mhrahimi/3d_printables/docs/images/01_example_wall.png

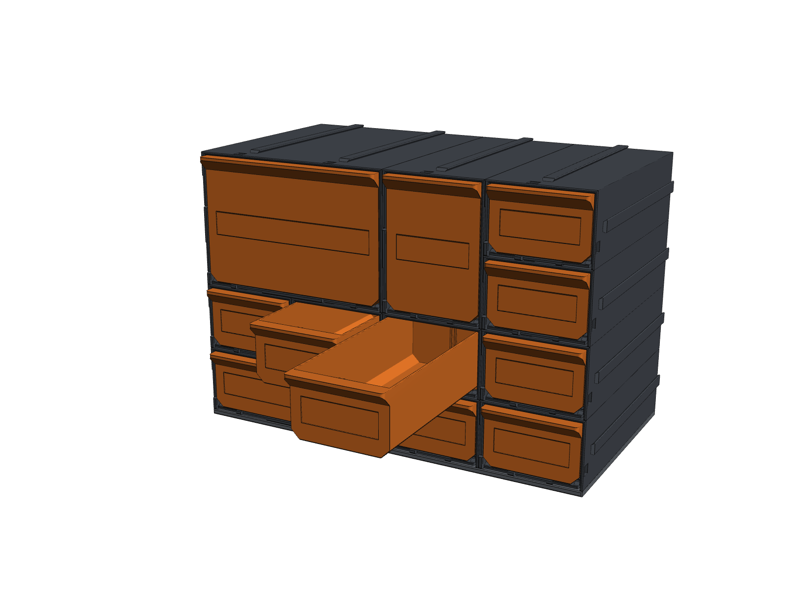
docs/images/01_example_wall.png
