mhrahimi/3d_printables/docs/images/02_example_wall_side.png

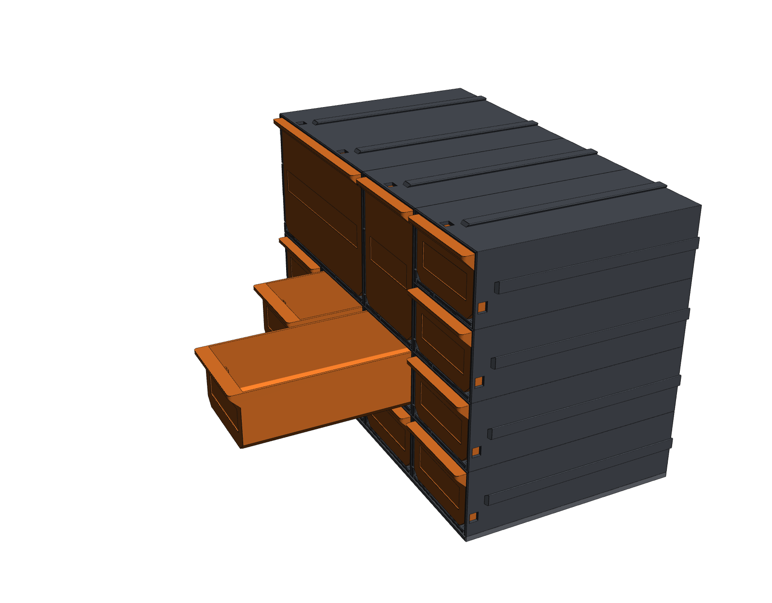
docs/images/02_example_wall_side.png
