mhrahimi/3d_printables/docs/images/03_module_1x1.png

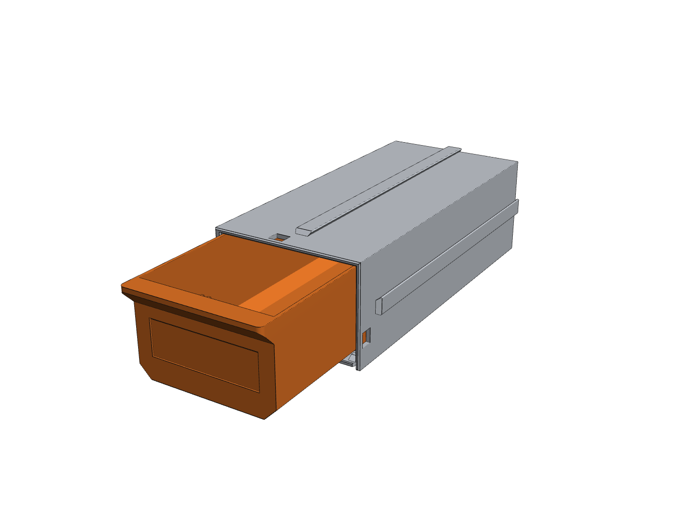
docs/images/03_module_1x1.png
