mhrahimi/3d_printables/docs/images/04_case_rear_bottom.png

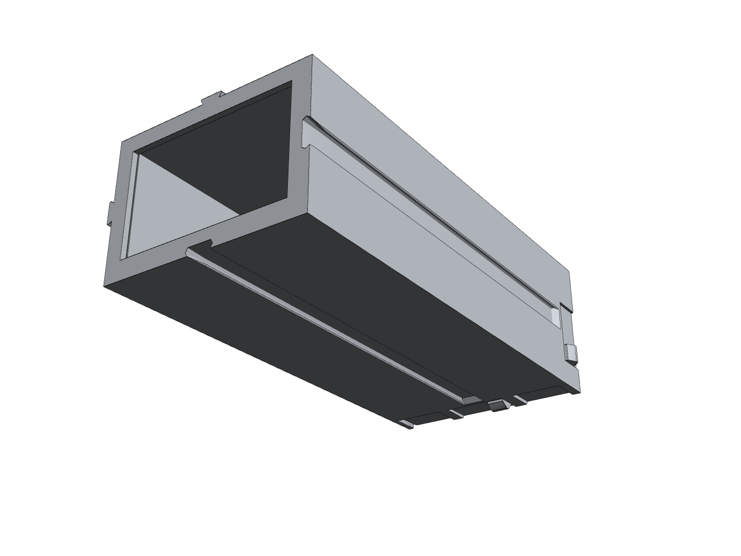
docs/images/04_case_rear_bottom.png
