mhrahimi/3d_printables/docs/images/05_joining_modules.png

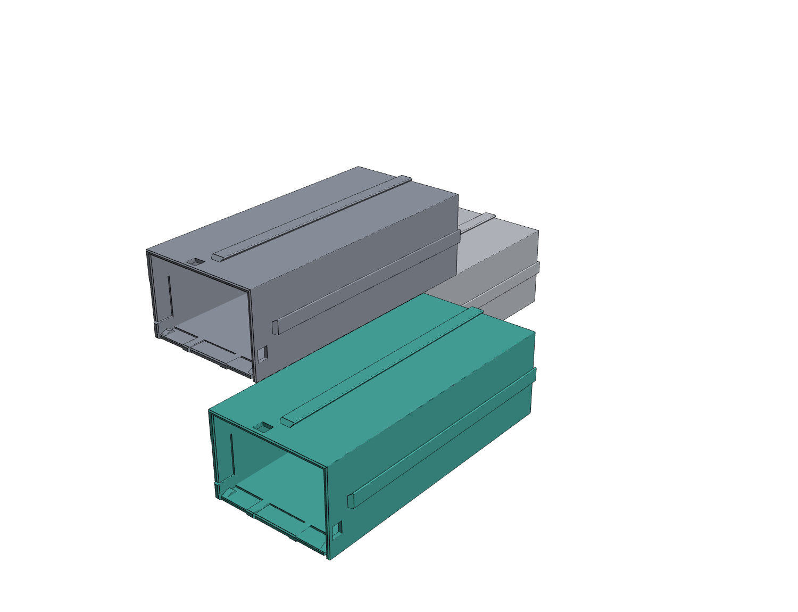
docs/images/05_joining_modules.png
