mhrahimi/3d_printables/docs/images/06_section_dovetail.png

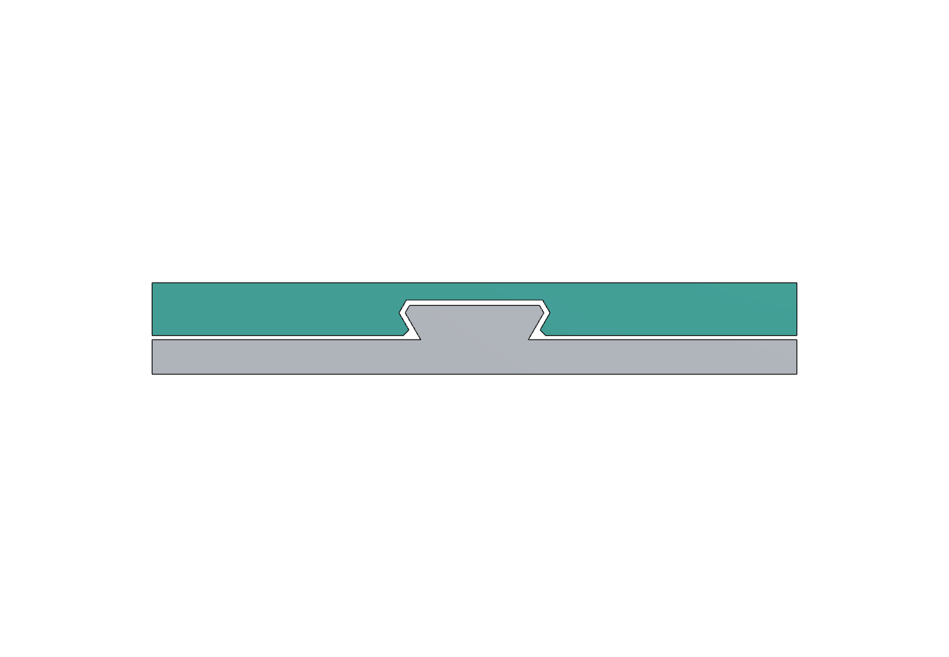
docs/images/06_section_dovetail.png
