mhrahimi/3d_printables/docs/images/07_section_lock.png

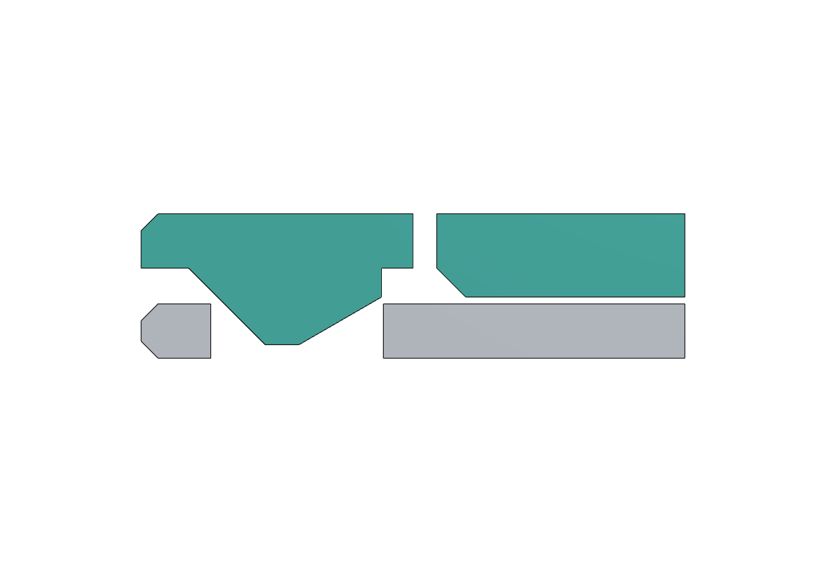
docs/images/07_section_lock.png
