mhrahimi/3d_printables/docs/images/08_section_drawer_stop.png

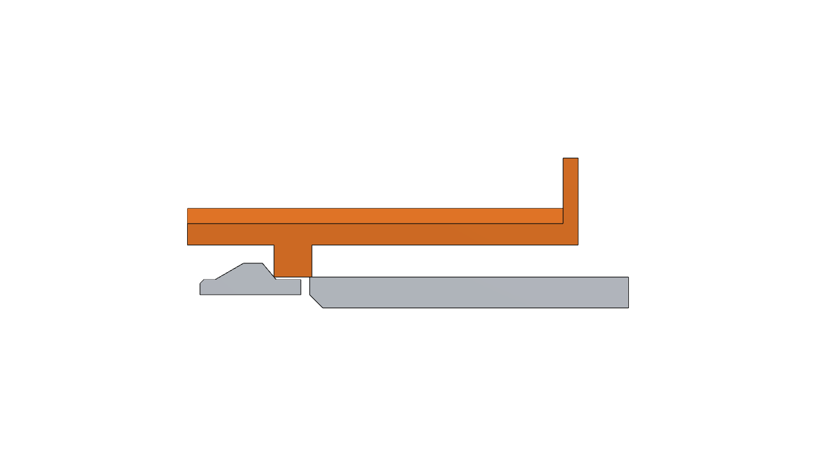
docs/images/08_section_drawer_stop.png
