mhrahimi/3d_printables/docs/images/09_drawer_at_stop.png

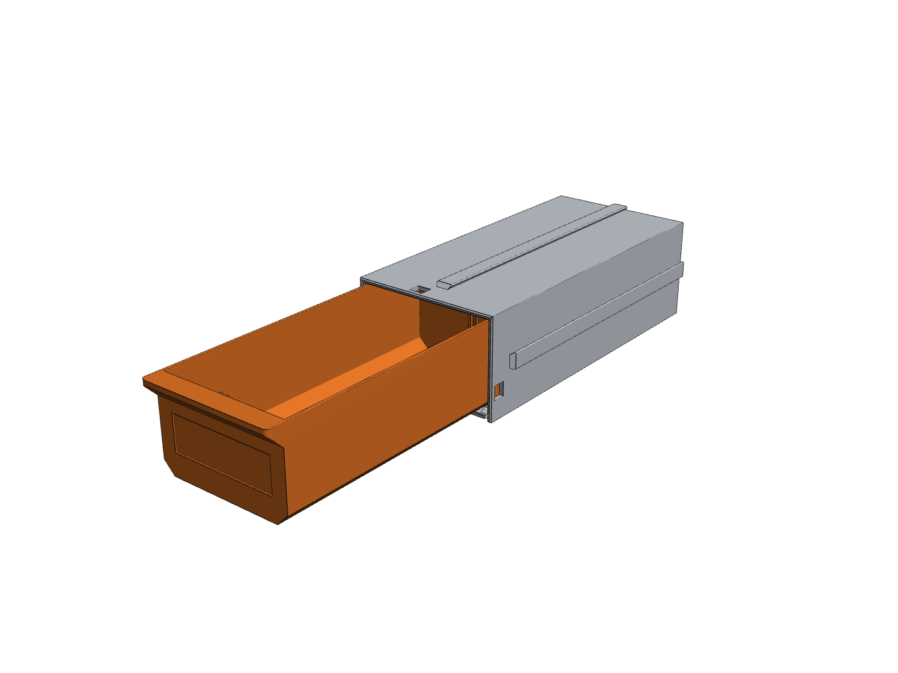
docs/images/09_drawer_at_stop.png
