mhrahimi/3d_printables/docs/images/10_flexures_from_below.png

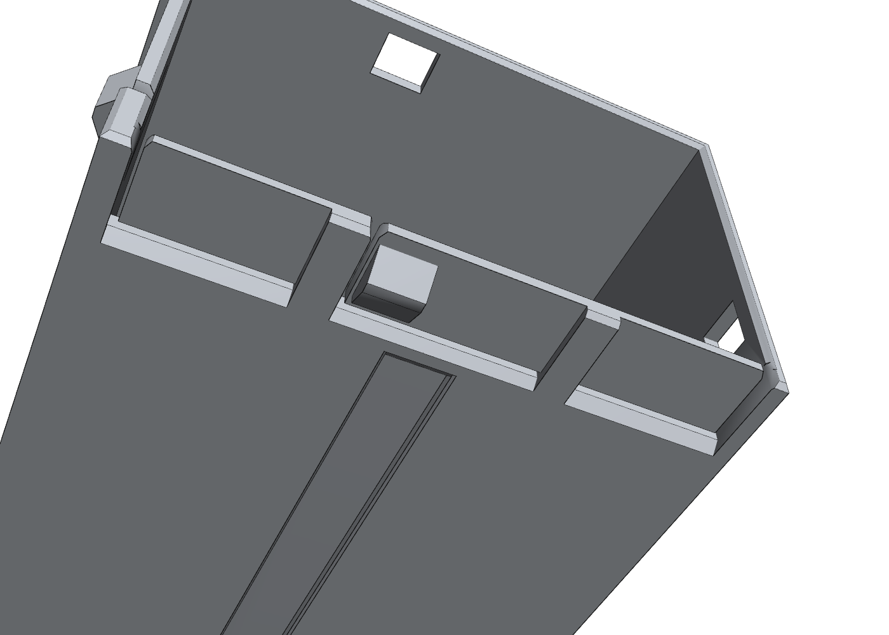
docs/images/10_flexures_from_below.png
