mhrahimi/3d_printables/docs/images/11_flexures_inside.png

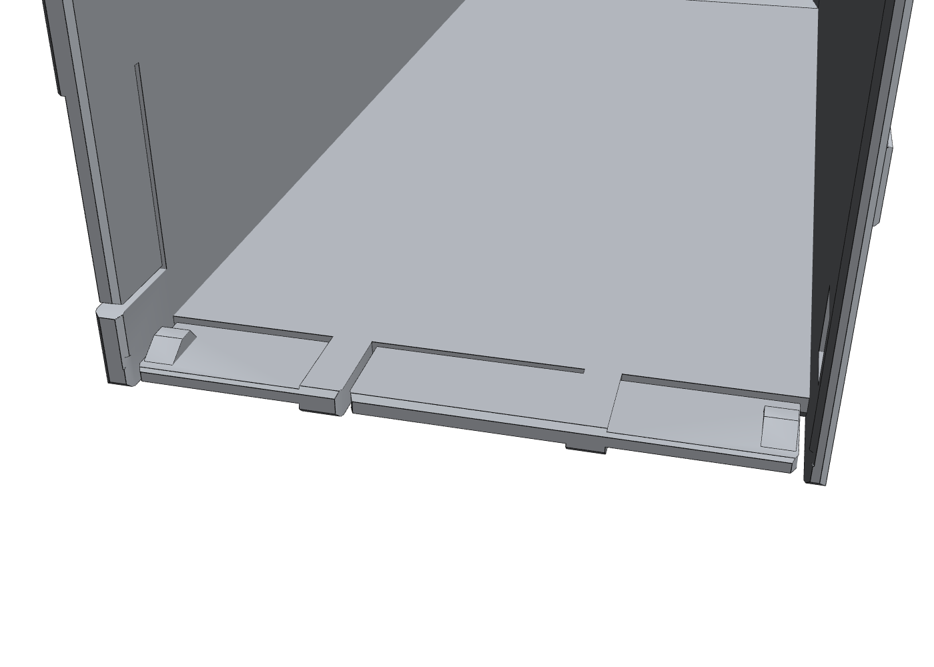
docs/images/11_flexures_inside.png
