mhrahimi/3d_printables/docs/images/12_drawer_1x1.png

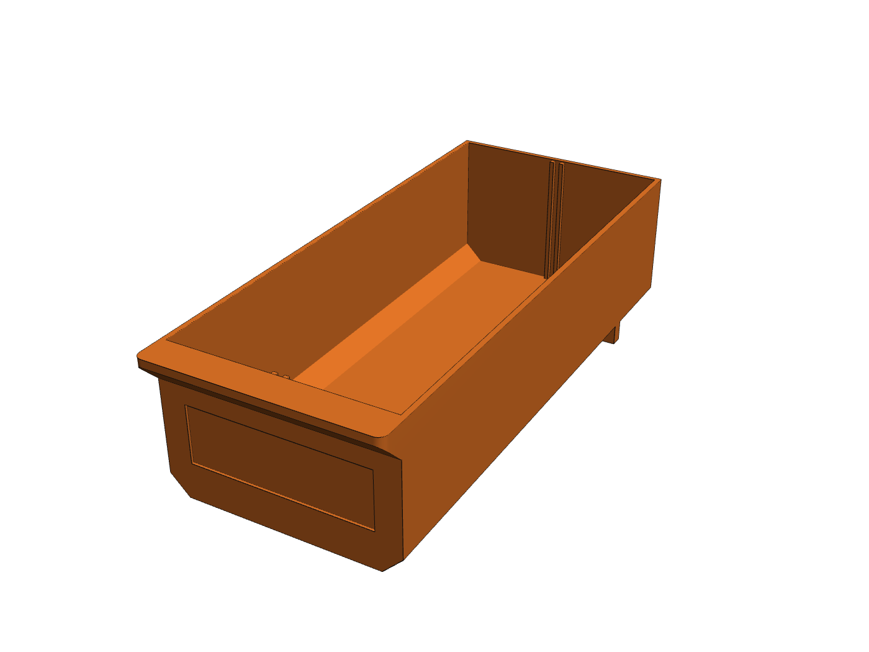
docs/images/12_drawer_1x1.png
