mhrahimi/3d_printables/docs/images/13_drawer_underside.png

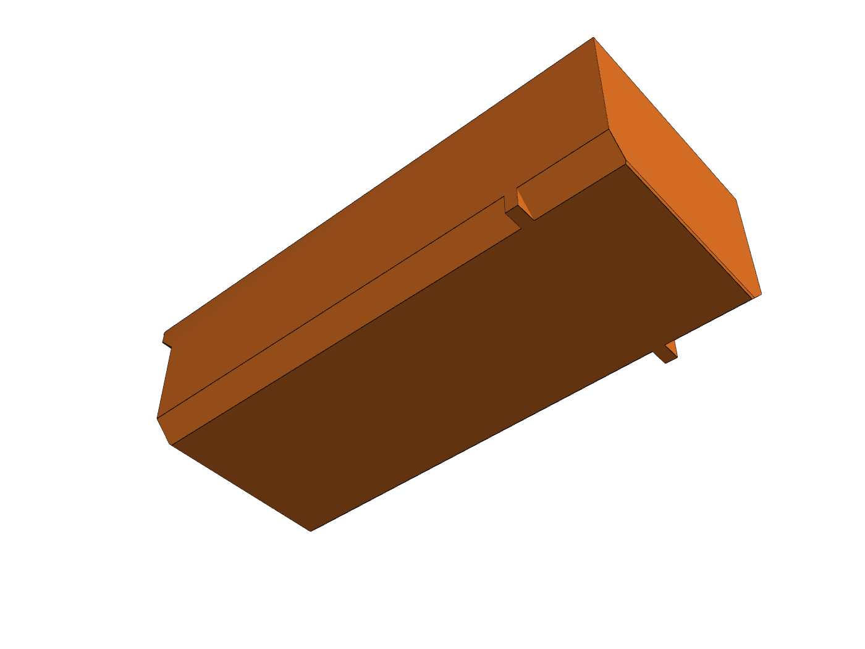
docs/images/13_drawer_underside.png
