mhrahimi/3d_printables/models/reports/parts.csv

part | kind | print_x | print_y | print_z | volume_cm3 | PLA_g | PETG_g
case_1x1 | case | 62.8 | 42.8 | 130.0 | 50.8 | 63.0 | 65.0
drawer_1x1 | drawer | 55.0 | 131.4 | 35.2 | 25.7 | 32.0 | 33.0
case_2x1 | case | 122.8 | 42.8 | 130.0 | 83.1 | 103.0 | 106.0
drawer_2x1 | drawer | 115.1 | 131.4 | 35.2 | 43.9 | 54.0 | 56.0
case_3x1 | case | 182.8 | 42.8 | 130.0 | 115.4 | 143.0 | 147.0
drawer_3x1 | drawer | 175.1 | 131.4 | 35.2 | 62.0 | 77.0 | 79.0
case_4x1 | case | 242.8 | 42.8 | 130.0 | 147.7 | 183.0 | 188.0
drawer_4x1 | drawer | 235.1 | 131.4 | 35.2 | 80.2 | 99.0 | 102.0
case_1x2 | case | 62.8 | 82.8 | 130.0 | 72.2 | 90.0 | 92.0
drawer_1x2 | drawer | 55.0 | 131.4 | 75.2 | 44.7 | 55.0 | 57.0
case_2x2 | case | 122.8 | 82.8 | 130.0 | 104.5 | 130.0 | 133.0
drawer_2x2 | drawer | 115.1 | 131.4 | 75.2 | 70.9 | 88.0 | 90.0
case_3x2 | case | 182.8 | 82.8 | 130.0 | 136.9 | 170.0 | 174.0
drawer_3x2 | drawer | 175.1 | 131.4 | 75.2 | 97.1 | 120.0 | 123.0
case_4x2 | case | 242.8 | 82.8 | 130.0 | 169.2 | 210.0 | 215.0
drawer_4x2 | drawer | 235.1 | 131.4 | 75.2 | 123.4 | 153.0 | 157.0
divider_h1 | divider | 121.7 | 33.2 | 1.2 | 4.8 | 6.0 | 6.0
divider_h2 | divider | 121.7 | 73.2 | 1.2 | 10.6 | 13.0 | 13.0
base_1 | base | 59.8 | 130.0 | 4.6 | 24.3 | 30.0 | 31.0
base_2 | base | 119.8 | 130.0 | 4.6 | 48.7 | 60.0 | 62.0
base_3 | base | 179.8 | 130.0 | 4.6 | 73.1 | 91.0 | 93.0
base_4 | base | 239.8 | 130.0 | 4.6 | 97.5 | 121.0 | 124.0
test_rail | coupon_rail | 28.0 | 10.2 | 30.0 | 2.1 | 3.0 | 3.0
test_groove_0.15mm_1notch | coupon_groove | 28.0 | 10.9 | 30.0 | 2.4 | 3.0 | 3.0
test_groove_0.20mm_2notch | coupon_groove | 28.0 | 10.9 | 30.0 | 2.4 | 3.0 | 3.0
test_groove_0.25mm_3notch | coupon_groove | 28.0 | 10.9 | 30.0 | 2.4 | 3.0 | 3.0
test_groove_0.30mm_4notch | coupon_groove | 28.0 | 10.9 | 30.0 | 2.4 | 3.0 | 3.0
test_groove_0.35mm_5notch | coupon_groove | 28.0 | 10.9 | 30.0 | 2.4 | 3.0 | 3.0
test_mini_case_1x1 | case | 62.8 | 42.8 | 48.0 | 19.3 | 24.0 | 25.0
test_mini_drawer_1x1 | drawer | 55.0 | 49.5 | 35.2 | 14.1 | 18.0 | 18.0
