mhrahimi/3d_printables/models/step/test_groove_0.25mm_3notch.step

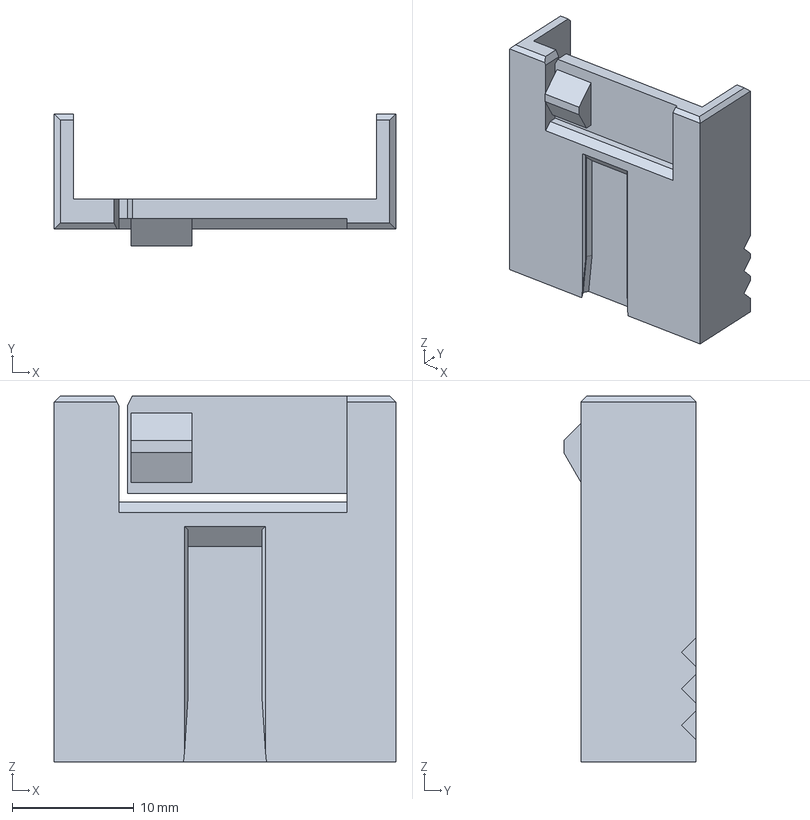
[picture p17: CAD file, 2026-11-12]
models/step/test_groove_0.25mm_3notch.step
28.0 x 10.9 x 30.0 mm
