mhrahimi/3d_printables/models/step/base_3.step

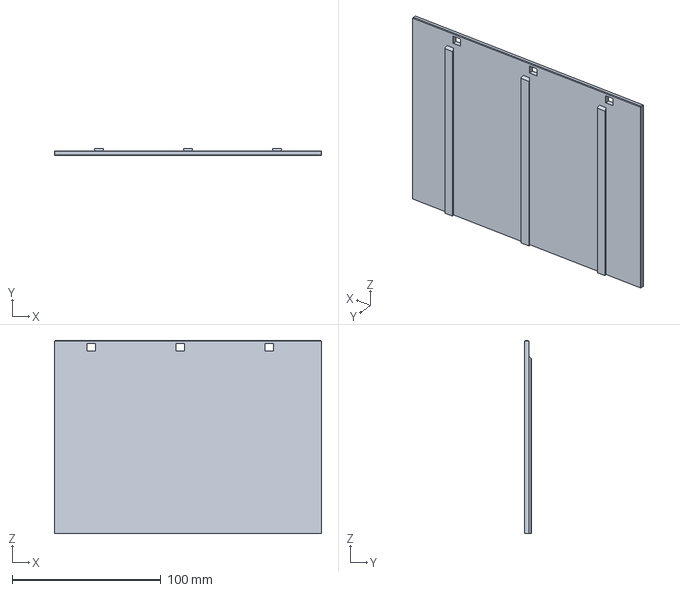
[picture p19: CAD file, 2026-11-12]
models/step/base_3.step
179.8 x 4.60 x 130.0 mm
