mhrahimi/3d_printables/models/step/test_rail.step

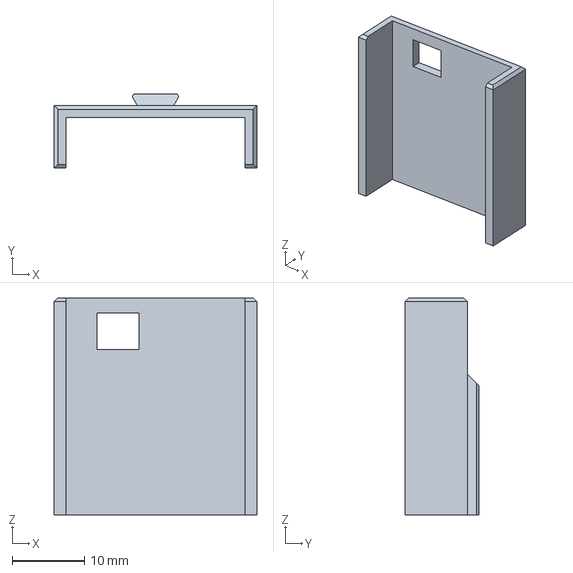
[picture p21: CAD file, 2026-11-12]
models/step/test_rail.step
28.0 x 10.2 x 30.0 mm
