mhrahimi/3d_printables/models/step/case_3x2.step

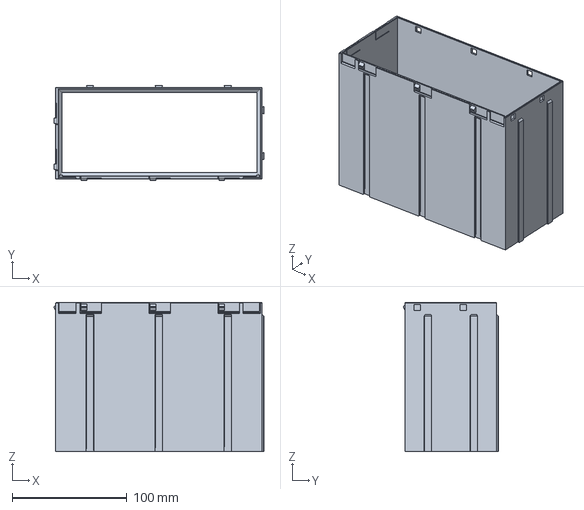
[picture p22: CAD file, 2026-11-12]
models/step/case_3x2.step
182.8 x 82.8 x 130.0 mm
