mhrahimi/3d_printables/models/step/case_2x1.step

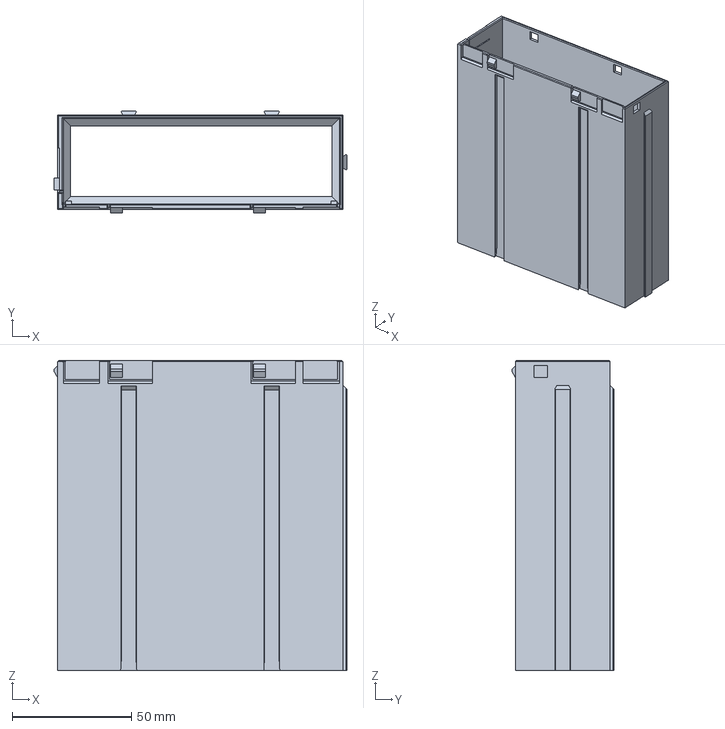
[picture p23: CAD file, 2026-11-12]
models/step/case_2x1.step
122.8 x 42.8 x 130.0 mm
