mhrahimi/3d_printables/models/step/drawer_4x1.step

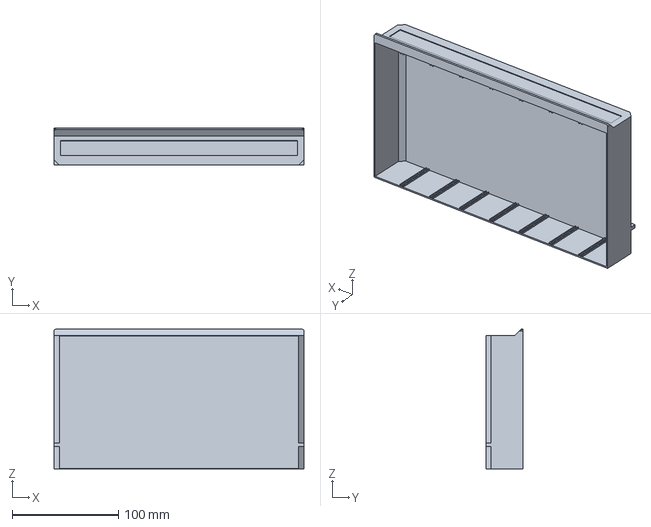
[picture p24: CAD file, 2026-11-12]
models/step/drawer_4x1.step
235.0 x 35.2 x 131.4 mm
