mhrahimi/3d_printables/models/step/drawer_1x1.step

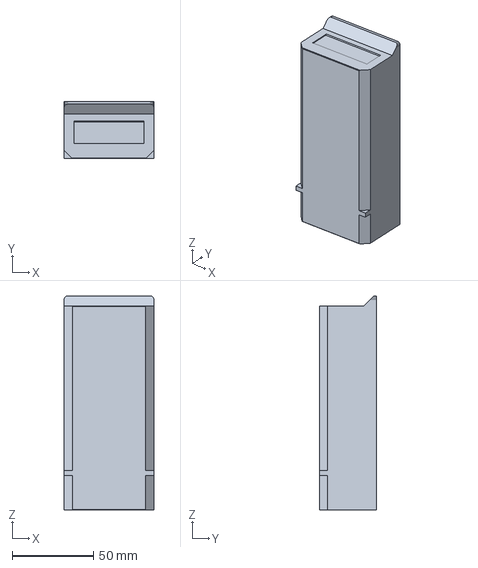
[picture p25: CAD file, 2026-11-12]
models/step/drawer_1x1.step
55.1 x 35.2 x 131.4 mm
