mhrahimi/3d_printables/models/step/case_4x1.step

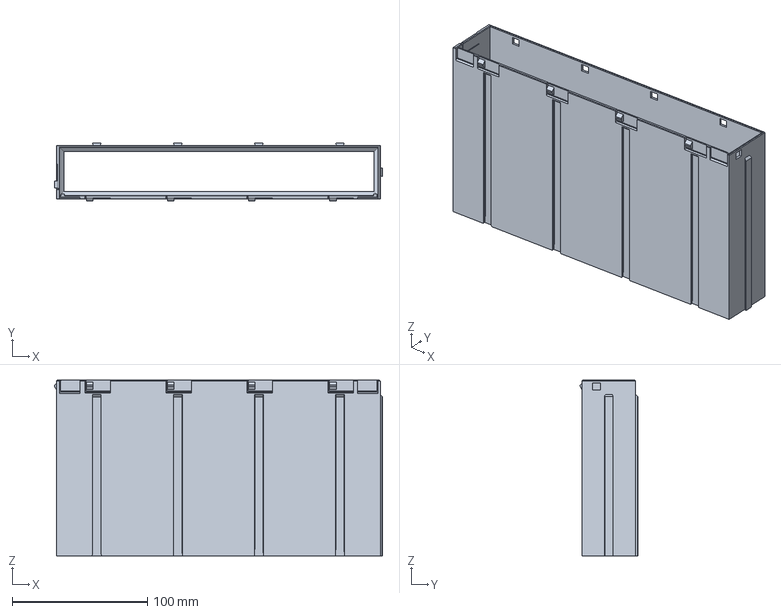
[picture p26: CAD file, 2026-11-12]
models/step/case_4x1.step
242.8 x 42.8 x 130.0 mm
