mhrahimi/3d_printables/models/step/divider_h2.step

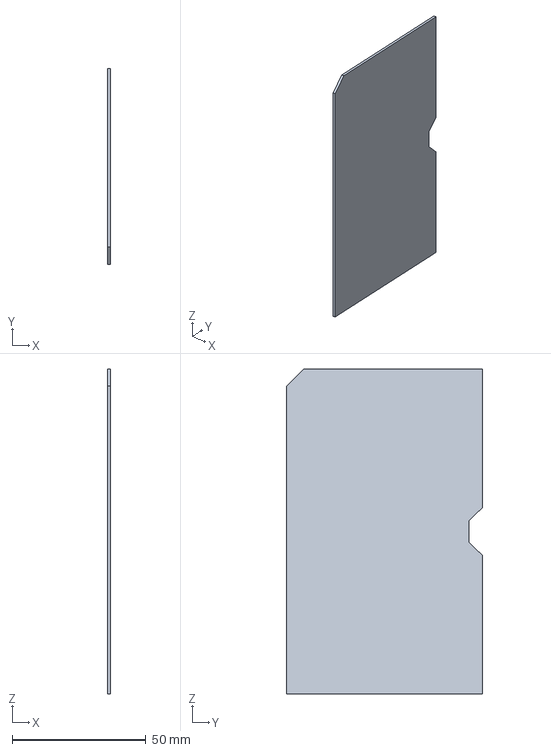
[picture p28: CAD file, 2026-11-12]
models/step/divider_h2.step
1.20 x 73.2 x 121.7 mm
