mhrahimi/3d_printables/models/step/base_1.step

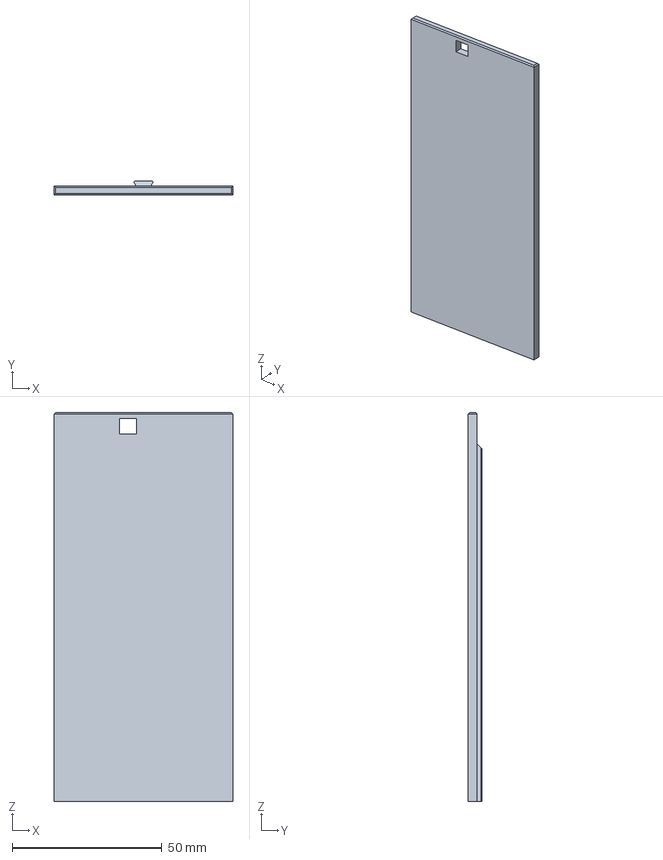
[picture p29: CAD file, 2026-11-12]
models/step/base_1.step
59.8 x 4.60 x 130.0 mm
