mhrahimi/3d_printables/models/step/base_4.step

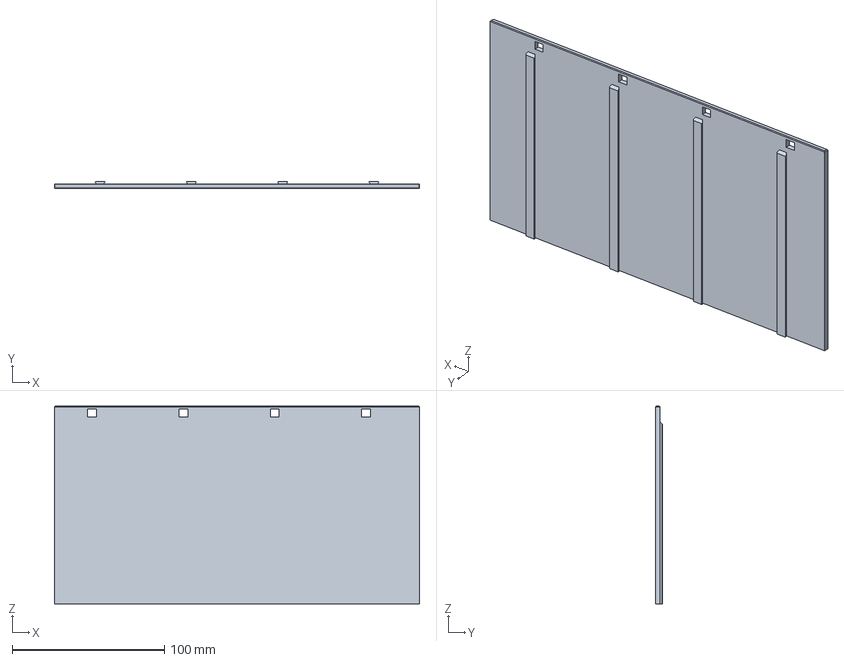
[picture p30: CAD file, 2026-11-12]
models/step/base_4.step
239.8 x 4.60 x 130.0 mm
