mhrahimi/3d_printables/models/step/case_3x1.step

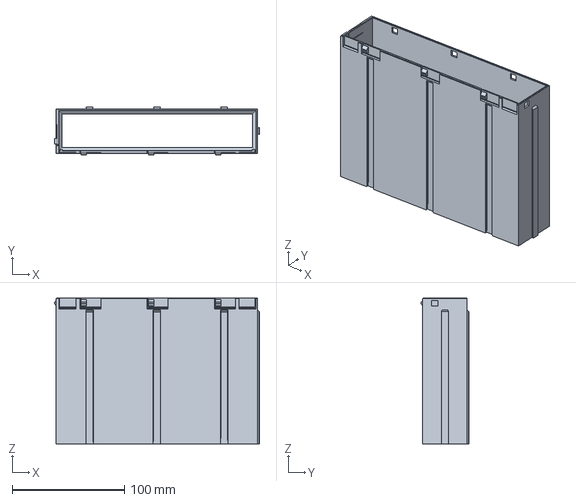
[picture p31: CAD file, 2026-11-12]
models/step/case_3x1.step
182.8 x 42.8 x 130.0 mm
