mhrahimi/3d_printables/models/step/base_2.step

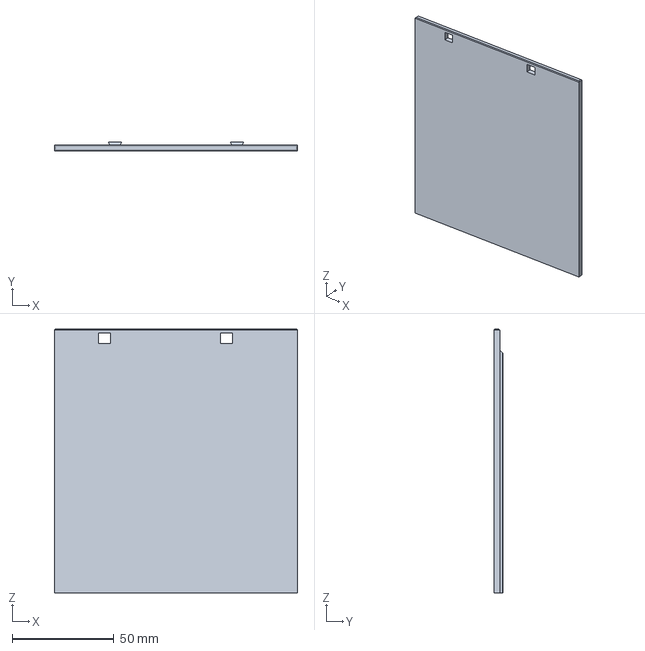
[picture p32: CAD file, 2026-11-12]
models/step/base_2.step
119.8 x 4.60 x 130.0 mm
