mhrahimi/3d_printables/models/step/drawer_3x2.step

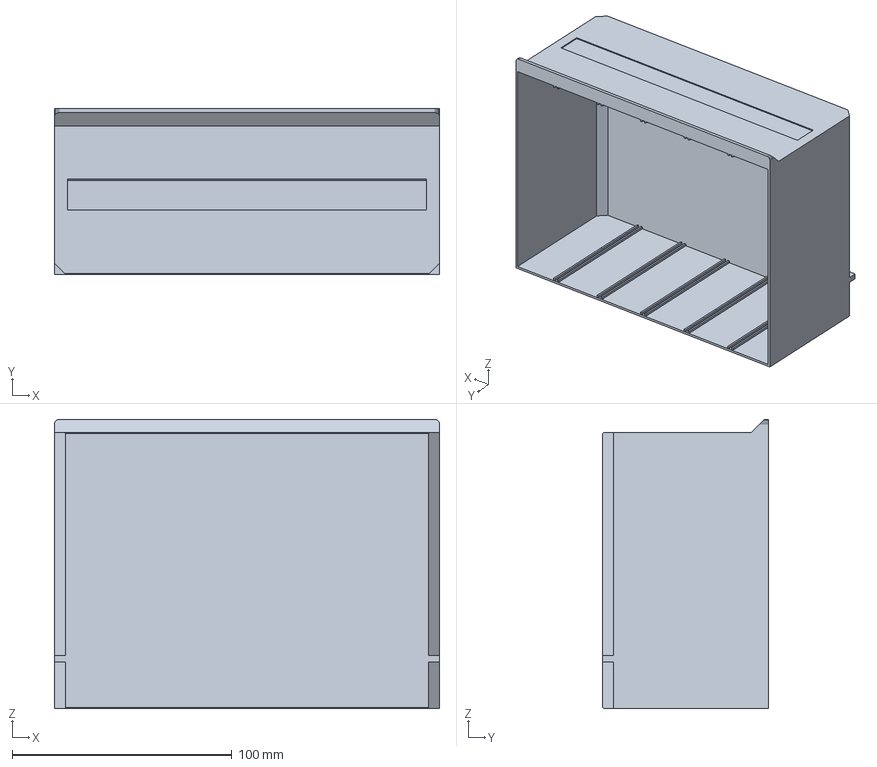
[picture p33: CAD file, 2026-11-12]
models/step/drawer_3x2.step
175.0 x 75.2 x 131.4 mm
