mhrahimi/3d_printables/models/step/case_1x1.step

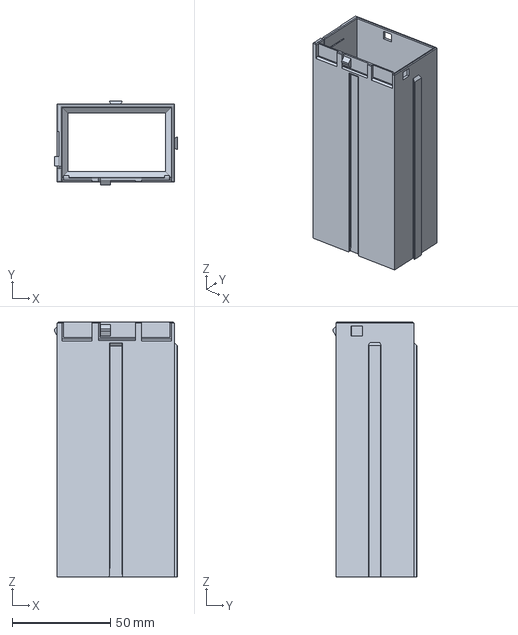
[picture p34: CAD file, 2026-11-12]
models/step/case_1x1.step
62.8 x 42.8 x 130.0 mm
