mhrahimi/3d_printables/models/step/case_1x2.step

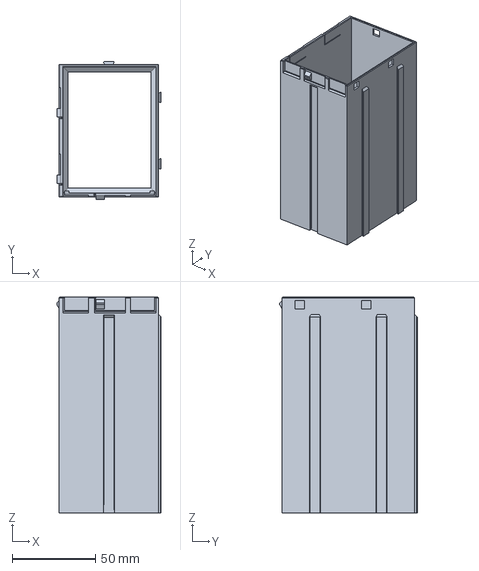
[picture p35: CAD file, 2026-11-12]
models/step/case_1x2.step
62.8 x 82.8 x 130.0 mm
