mhrahimi/3d_printables/models/step/drawer_2x2.step

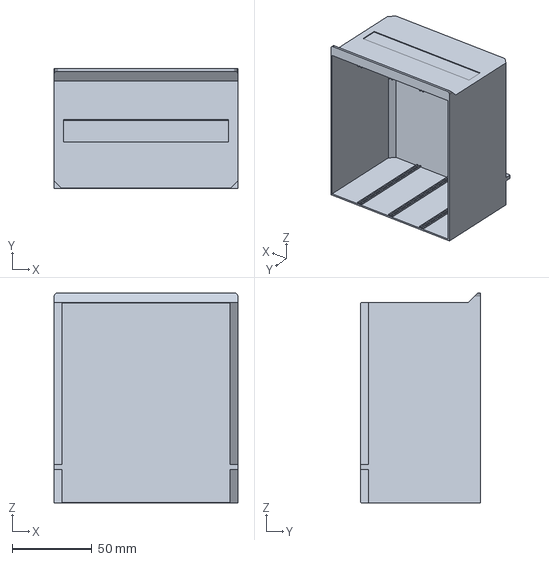
[picture p36: CAD file, 2026-11-12]
models/step/drawer_2x2.step
115.0 x 75.2 x 131.4 mm
