mhrahimi/3d_printables/models/step/divider_h1.step

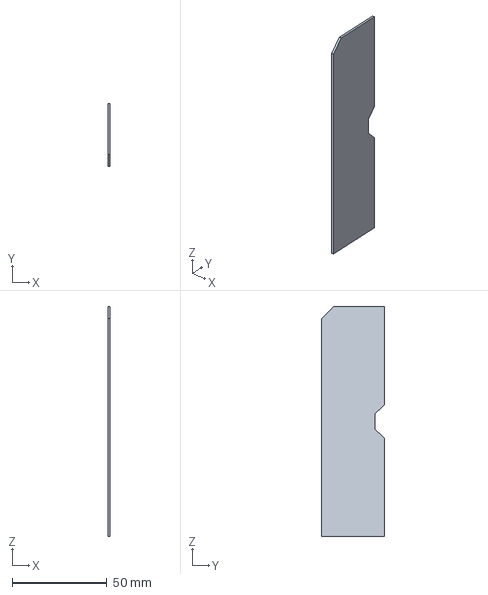
[picture p37: CAD file, 2026-11-12]
models/step/divider_h1.step
1.20 x 33.2 x 121.7 mm
