mhrahimi/3d_printables/models/step/test_mini_drawer_1x1.step

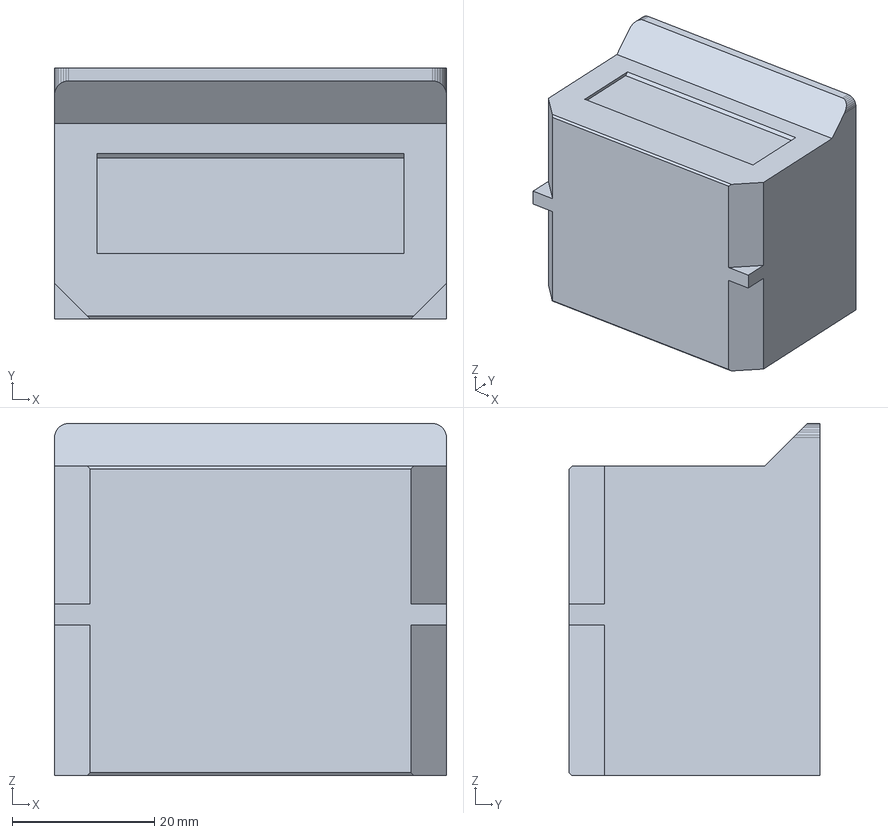
[picture p38: CAD file, 2026-11-12]
models/step/test_mini_drawer_1x1.step
55.1 x 35.2 x 49.5 mm
