mhrahimi/3d_printables/models/step/drawer_1x2.step

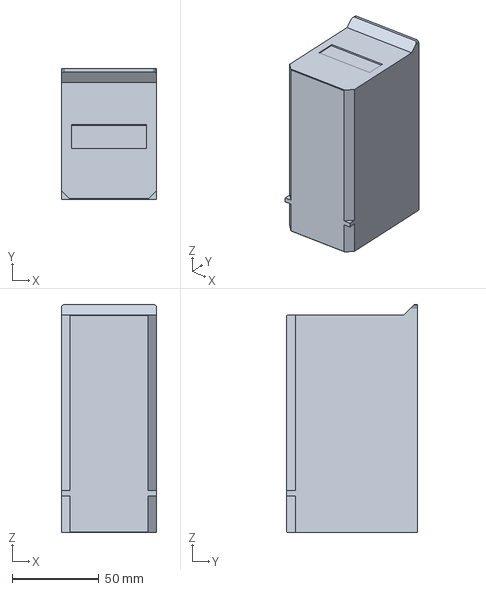
[picture p39: CAD file, 2026-11-12]
models/step/drawer_1x2.step
55.1 x 75.2 x 131.4 mm
