mhrahimi/3d_printables/models/step/drawer_3x1.step

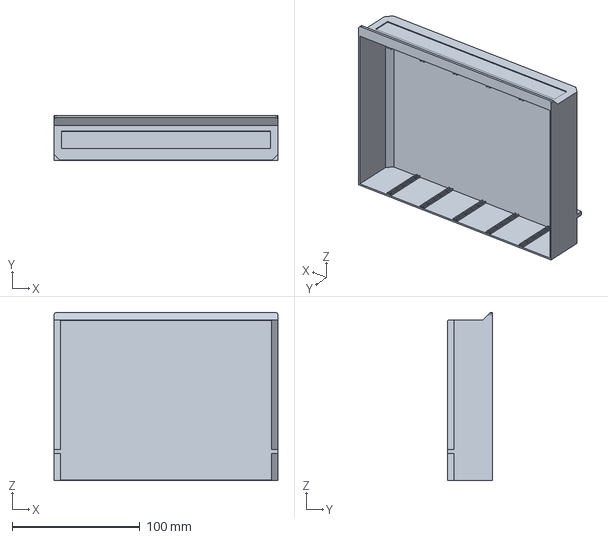
[picture p40: CAD file, 2026-11-12]
models/step/drawer_3x1.step
175.0 x 35.2 x 131.4 mm
