mhrahimi/3d_printables/models/step/case_4x2.step

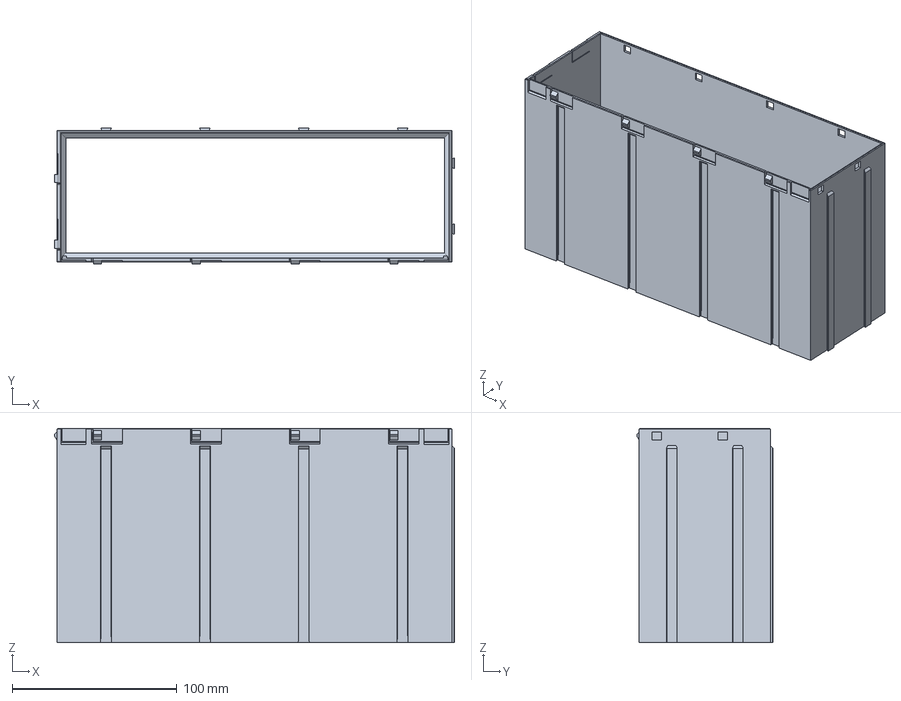
[picture p41: CAD file, 2026-11-12]
models/step/case_4x2.step
242.8 x 82.8 x 130.0 mm
