mhrahimi/3d_printables/models/step/test_mini_case_1x1.step

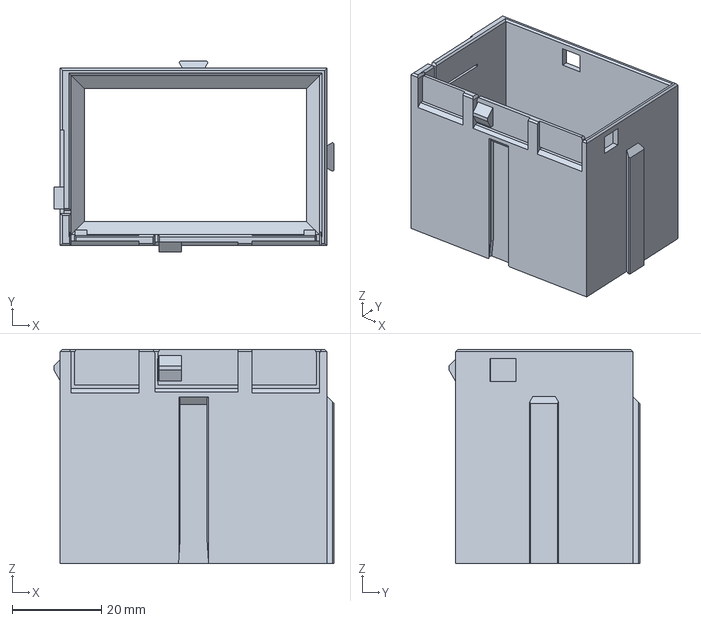
[picture p42: CAD file, 2026-11-12]
models/step/test_mini_case_1x1.step
62.8 x 42.8 x 48.0 mm
