mhrahimi/3d_printables/models/step/example_wall.step

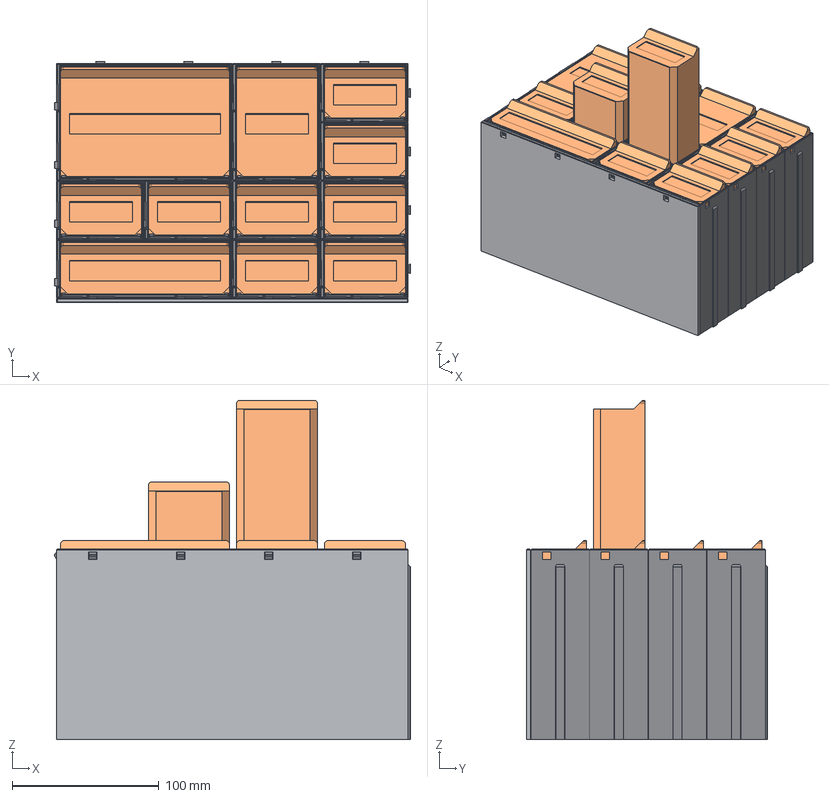
[picture p43: CAD file, 2026-11-12]
models/step/example_wall.step
242.8 x 164.6 x 231.4 mm
base_4
case_2x1_c0r0
drawer_2x1_c0r0
case_1x1_c2r0
drawer_1x1_c2r0
case_1x1_c3r0
drawer_1x1_c3r0
case_1x1_c0r1
drawer_1x1_c0r1
case_1x1_c1r1
drawer_1x1_c1r1
case_1x1_c2r1
drawer_1x1_c2r1
case_1x1_c3r1
drawer_1x1_c3r1
case_2x2_c0r2
drawer_2x2_c0r2
case_1x2_c2r2
drawer_1x2_c2r2
case_1x1_c3r2
drawer_1x1_c3r2
case_1x1_c3r3
drawer_1x1_c3r3
