mhrahimi/3d_printables/(list of files, cad)

Other CAD files:
models/step/test_groove_0.30mm_4notch.step
models/step/test_groove_0.35mm_5notch.step
models/step/test_groove_0.15mm_1notch.step
models/step/test_groove_0.20mm_2notch.step
models/stl/base_1.stl
models/stl/base_2.stl
models/stl/base_3.stl
models/stl/base_4.stl
models/stl/case_1x1.stl
models/stl/case_1x2.stl
models/stl/case_2x1.stl
models/stl/case_2x2.stl
models/stl/case_3x1.stl
models/stl/case_3x2.stl
models/stl/case_4x1.stl
models/stl/case_4x2.stl
models/stl/divider_h1.stl
models/stl/divider_h2.stl
models/stl/drawer_1x1.stl
models/stl/drawer_1x2.stl
models/stl/drawer_2x1.stl
models/stl/drawer_2x2.stl
models/stl/drawer_3x1.stl
models/stl/drawer_3x2.stl
models/stl/drawer_4x1.stl
models/stl/drawer_4x2.stl
models/stl/test_groove_0.15mm_1notch.stl
models/stl/test_groove_0.20mm_2notch.stl
models/stl/test_groove_0.25mm_3notch.stl
models/stl/test_groove_0.30mm_4notch.stl
models/stl/test_groove_0.35mm_5notch.stl
models/stl/test_mini_case_1x1.stl
models/stl/test_mini_drawer_1x1.stl
models/stl/test_rail.stl
