mhrahimi/3d_printables/models/reports/printcheck.txt

OK  base_1                           59.8 x  130.0 x    4.6  watertight=True  unsupported=0  bridges=0 (longest 0.0 mm)
OK  base_2                          119.8 x  130.0 x    4.6  watertight=True  unsupported=0  bridges=0 (longest 0.0 mm)
OK  base_3                          179.8 x  130.0 x    4.6  watertight=True  unsupported=0  bridges=0 (longest 0.0 mm)
OK  base_4                          239.8 x  130.0 x    4.6  watertight=True  unsupported=0  bridges=0 (longest 0.0 mm)
OK  case_1x1                         62.8 x   42.8 x  130.0  watertight=True  unsupported=0  bridges=6 (longest 18.7 mm)
OK  case_1x2                         62.8 x   82.8 x  130.0  watertight=True  unsupported=0  bridges=8 (longest 18.7 mm)
OK  case_2x1                        122.8 x   42.8 x  130.0  watertight=True  unsupported=0  bridges=8 (longest 18.7 mm)
OK  case_2x2                        122.8 x   82.8 x  130.0  watertight=True  unsupported=0  bridges=10 (longest 18.7 mm)
OK  case_3x1                        182.8 x   42.8 x  130.0  watertight=True  unsupported=0  bridges=10 (longest 18.7 mm)
OK  case_3x2                        182.8 x   82.8 x  130.0  watertight=True  unsupported=0  bridges=12 (longest 18.7 mm)
OK  case_4x1                        242.8 x   42.8 x  130.0  watertight=True  unsupported=0  bridges=12 (longest 18.7 mm)
OK  case_4x2                        242.8 x   82.8 x  130.0  watertight=True  unsupported=0  bridges=14 (longest 18.7 mm)
OK  divider_h1                      121.7 x   33.2 x    1.2  watertight=True  unsupported=0  bridges=0 (longest 0.0 mm)
OK  divider_h2                      121.7 x   73.2 x    1.2  watertight=True  unsupported=0  bridges=0 (longest 0.0 mm)
OK  drawer_1x1                       55.0 x  131.4 x   35.2  watertight=True  unsupported=0  bridges=0 (longest 0.0 mm)
OK  drawer_1x2                       55.0 x  131.4 x   75.2  watertight=True  unsupported=0  bridges=0 (longest 0.0 mm)
OK  drawer_2x1                      115.1 x  131.4 x   35.2  watertight=True  unsupported=0  bridges=0 (longest 0.0 mm)
OK  drawer_2x2                      115.1 x  131.4 x   75.2  watertight=True  unsupported=0  bridges=0 (longest 0.0 mm)
OK  drawer_3x1                      175.1 x  131.4 x   35.2  watertight=True  unsupported=0  bridges=0 (longest 0.0 mm)
OK  drawer_3x2                      175.1 x  131.4 x   75.2  watertight=True  unsupported=0  bridges=0 (longest 0.0 mm)
OK  drawer_4x1                      235.1 x  131.4 x   35.2  watertight=True  unsupported=0  bridges=0 (longest 0.0 mm)
OK  drawer_4x2                      235.1 x  131.4 x   75.2  watertight=True  unsupported=0  bridges=0 (longest 0.0 mm)
OK  test_groove_0.15mm_1notch        28.0 x   10.9 x   30.0  watertight=True  unsupported=0  bridges=1 (longest 18.7 mm)
OK  test_groove_0.20mm_2notch        28.0 x   10.9 x   30.0  watertight=True  unsupported=0  bridges=1 (longest 18.7 mm)
OK  test_groove_0.25mm_3notch        28.0 x   10.9 x   30.0  watertight=True  unsupported=0  bridges=1 (longest 18.7 mm)
OK  test_groove_0.30mm_4notch        28.0 x   10.9 x   30.0  watertight=True  unsupported=0  bridges=1 (longest 18.7 mm)
OK  test_groove_0.35mm_5notch        28.0 x   10.9 x   30.0  watertight=True  unsupported=0  bridges=1 (longest 18.7 mm)
OK  test_mini_case_1x1               62.8 x   42.8 x   48.0  watertight=True  unsupported=0  bridges=6 (longest 18.7 mm)
OK  test_mini_drawer_1x1             55.0 x   49.5 x   35.2  watertight=True  unsupported=0  bridges=0 (longest 0.0 mm)
OK  test_rail                        28.0 x   10.2 x   30.0  watertight=True  unsupported=0  bridges=1 (longest 5.5 mm)

30 meshes, 0 with problems
