mhrahimi/3d_printables/docs/images/14_print_orientation.png

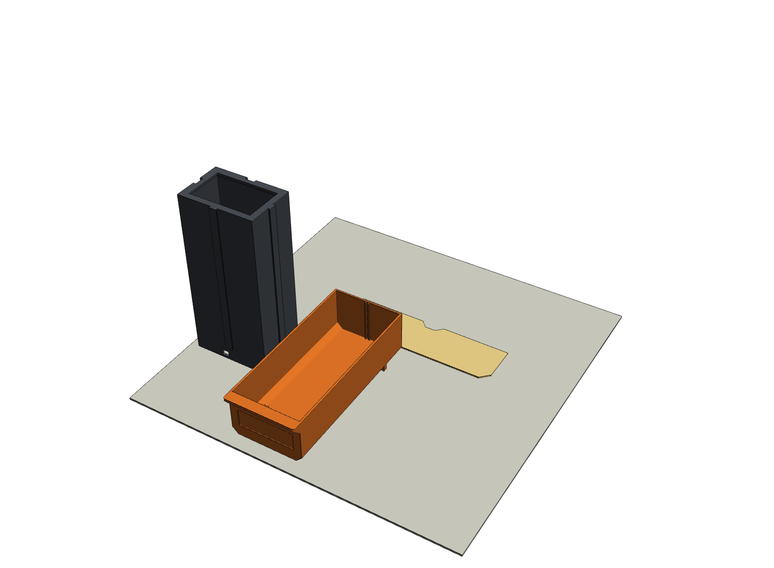
docs/images/14_print_orientation.png
