mhrahimi/3d_printables/docs/images/builder_phone.png

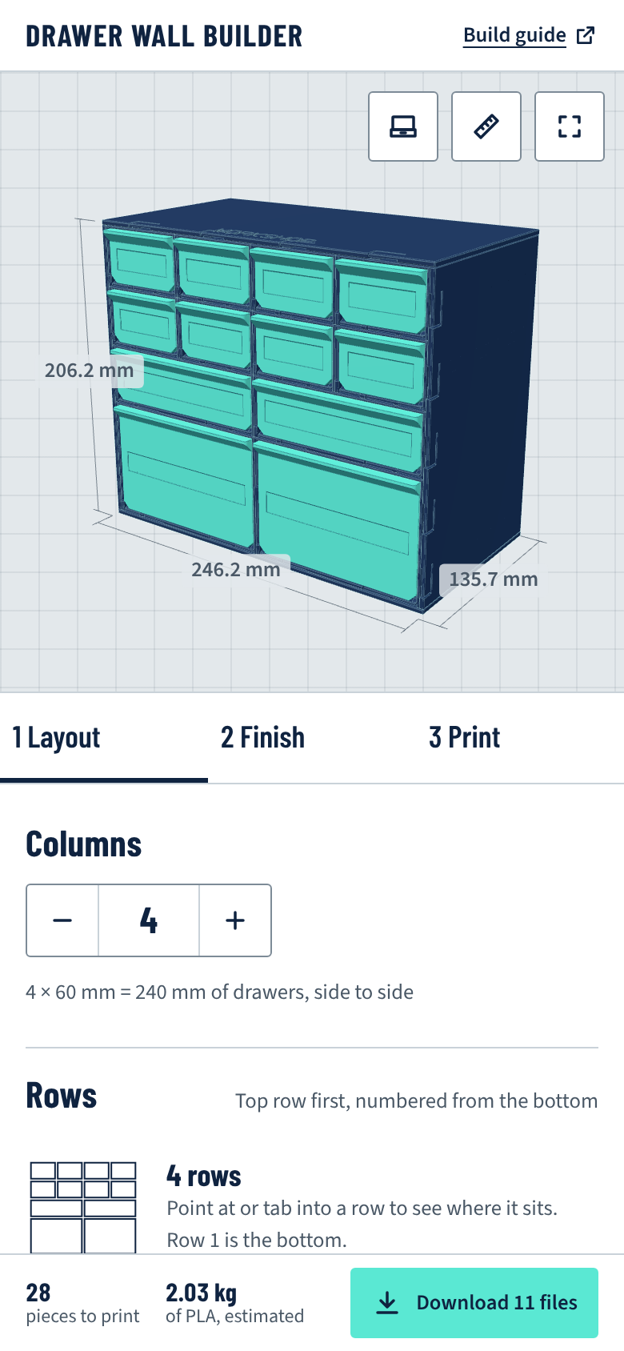
docs/images/builder_phone.png
