mhrahimi/3d_printables/docs/images/15_test_kit.png

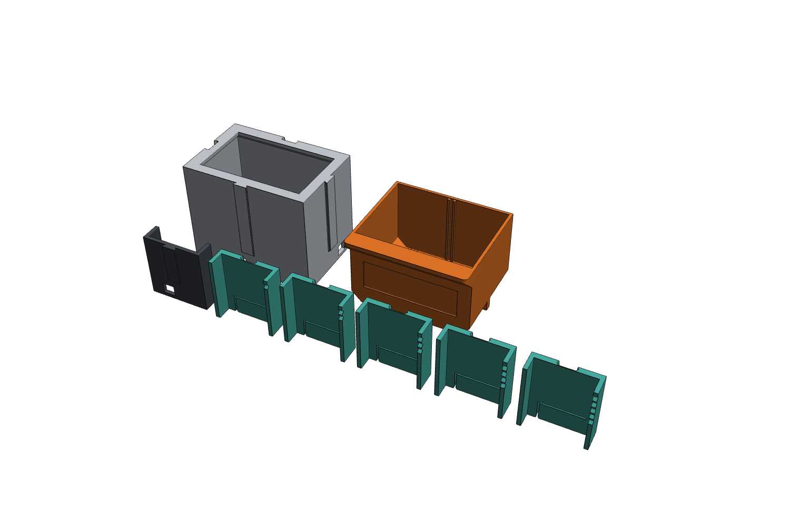
docs/images/15_test_kit.png
