mhrahimi/3d_printables/(commit log)

2026-11-12 Add builder, docs, images, CAD source and reference models
    The first commit only had the README, so its images and links had nothing to point to.
    This adds the GitHub Pages builder (index.html), the build guide and images in docs/,
    the builder source and tests in web/, the CadQuery source in cad/, reference STL/STEP
    models, licence, changelog, contributing guide, issue and PR templates and CI.
    Links now use the repository name 3d_printables.
    Claude-Session: https://claude.ai/code/session_017LG5NgR9oydYWwK1GzzbPP
    [base_1.step, base_1.stl, base_2.step, base_2.stl, base_3.step, base_3.stl, base_4.step, base_4.stl]
2026-11-12 Add filament presets, drawer fit test, sturdy rails, finger notch, wall and slide tests
    - Filament choice (PLA, PETG, ABS/ASA) sets the starting rail and drawer clearances;
    clearances are fine-tuned as offsets from the preset under Advanced.
    - Test kit: groove pieces centred on the preset, plus a drawer opening and three slices.
    - Sturdy rail option (2.0 mm high, 6 mm neck) in the builder and cad/build.py --rails.
    - Finger-notch drawer pull as an alternative to the lip.
    - New tests: whole walls checked part against part, and insertion paths swept for contact.
    - Docs: filament page and "Where the numbers come from", linked from the builder and README.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
2026-11-12 List rows top first, make legs optional, choose panel pieces per side
    - Rows in the side panel are listed top row first, as on the wall (numbered from the bottom).
    - Legs are off by default (base plate); when on they start at 7.5 mm, 5-120 mm in 2.5 mm steps.
    - Panel pieces (bed-length or one per column/row) are set separately for top, sides and bottom.
    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
2026-11-12 Add Open in Kiri:Moto for one part or the whole set
    Sends the generated STLs to Grid.Space's browser slicer through its
    iframe message API; odd triangle counts are padded so Kiri's binary
    STL reader accepts them.
    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
2026-11-12 Move Kiri:Moto into the Print tab and send parts the way the live site accepts
    Kiri:Moto 4.7.3 never adds parts sent with {parse}, so each part now goes
    as a data: URL through {load}. The bed is cleared first and, on a cold
    start, filled once more after Kiri restores its last workspace.
    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
2026-11-12 Start with no finish panels, icon-only view buttons, test kit by the download
    - Top, sides and bottom default to None; saved designs on the old defaults follow.
    - Open drawers, dimensions and reset view are icon buttons (cabinet, ruler, home).
    - The fit test kit switch moves to the top bar next to the download button.
    - Remove the footer notes.
    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
2026-11-12 Give the fit test kit its own page, linked beside the build guide
    - New docs/fit-test-kit.md with a ready-made ZIP per filament and rail
    size (docs/kits), instructions and the preset table.
    - web/tools/make_kits.mjs (npm run kits) builds the ZIPs from the builder's
    own presets; the files match what the builder produced byte for byte.
    - The builder drops the kit checkbox and no longer adds test_kit/ to the
    download; its README and Advanced section link to the page instead.
    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
2026-11-12 Choose filament and rail size on the fit test kit page and download
    The page gets a small form (filament, rail size, download button) that
    picks the matching ZIP. The builder's header link passes its current
    filament and rail size, so the right kit is already selected.
    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
2026-11-12 Add slim side strips: one per row, tied together by a rod
    Side pieces are now One piece or One per row; per-row pieces are Wide
    (full depth) or Slim: a 30 mm strip at the front of each row, locked on
    like a panel, with one rod channel behind the lock spring so a single
    rod runs through every row on each side. Works with any side style
    (labels are left off). New test suite (748 checks) covers solids, fit,
    locks, sliding, rod and plugs for rods 3-12 mm; the whole-wall test gets
    a slim wall.
    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
